THP-dr/drosos/Flowcharts/Xatz_allFlowcharts.pdf

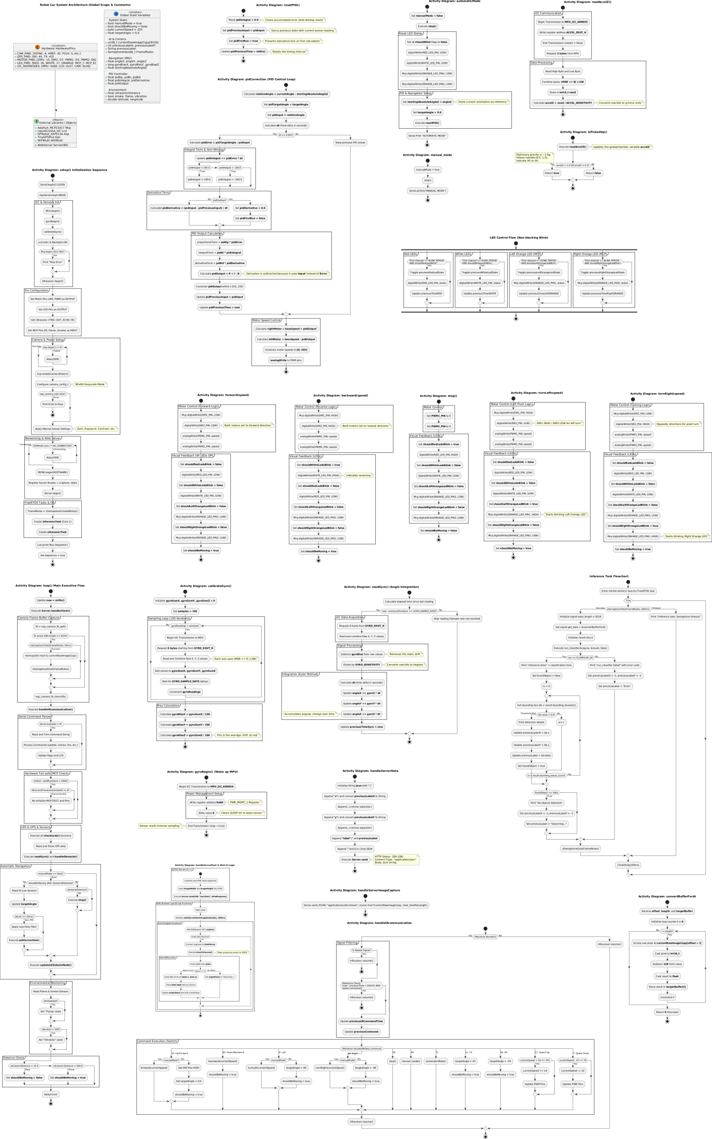
[picture p78: page 1]
