THP-dr/drosos/docs/cad/chassis_back.png

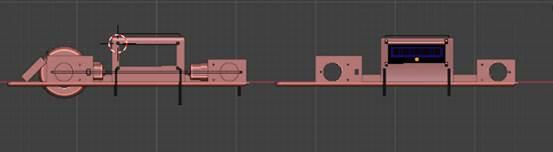
docs/cad/chassis_back.png
