THP-dr/drosos/docs/cad/chassis_front.png

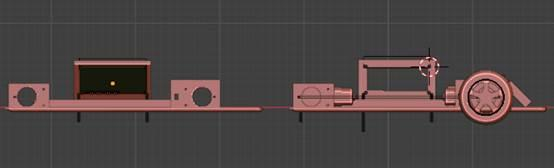
docs/cad/chassis_front.png
