THP-dr/drosos/docs/flowcharts/checkLeds.png

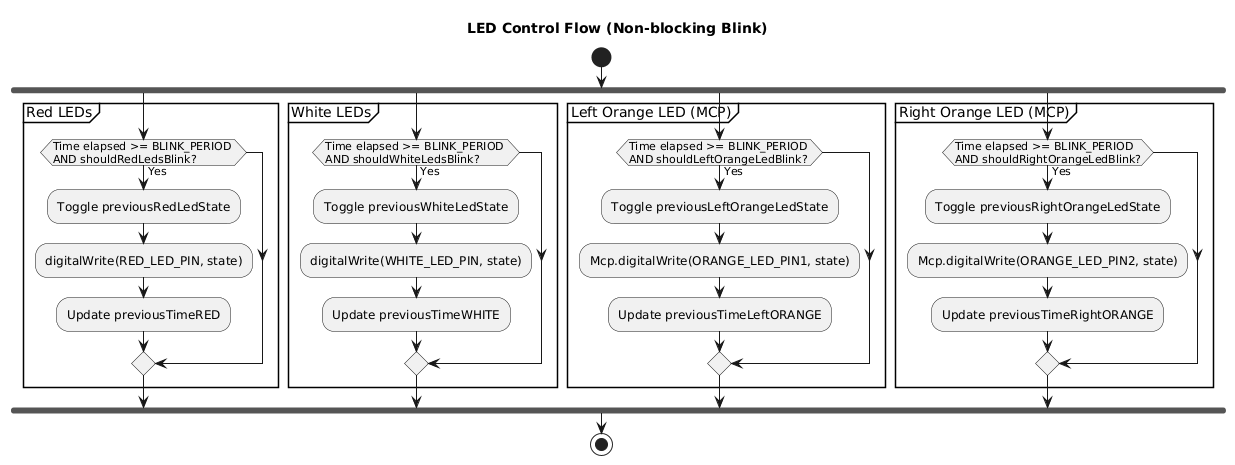
docs/flowcharts/checkLeds.png
