THP-dr/drosos/docs/flowcharts/early/sensors.png

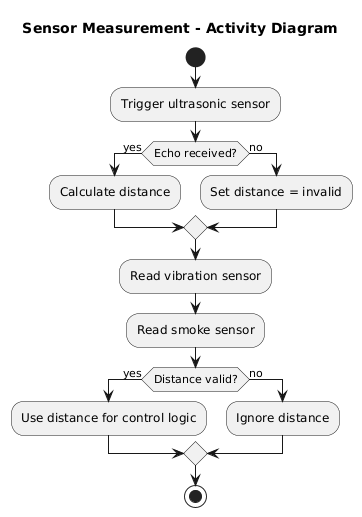
docs/flowcharts/early/sensors.png
