THP-dr/drosos/docs/flowcharts/early/streaming-2.png

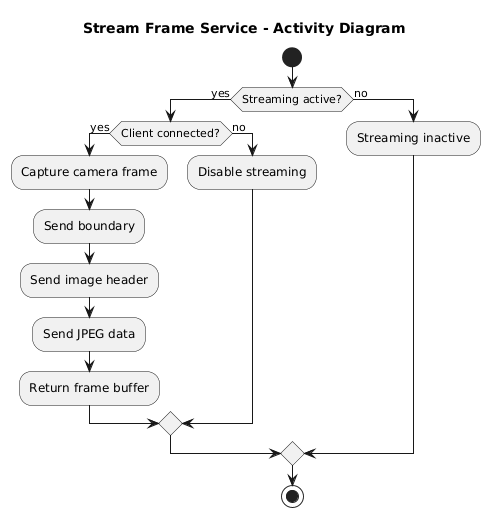
docs/flowcharts/early/streaming-2.png
