THP-dr/drosos/docs/flowcharts/handleImageCapture.png

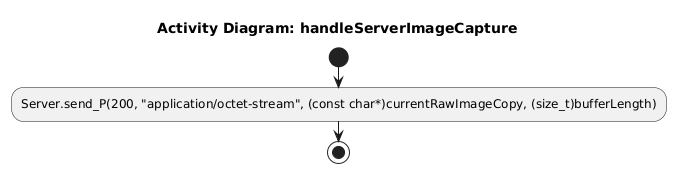
docs/flowcharts/handleImageCapture.png
