THP-dr/drosos/docs/flowcharts/handleIRcommunication.png

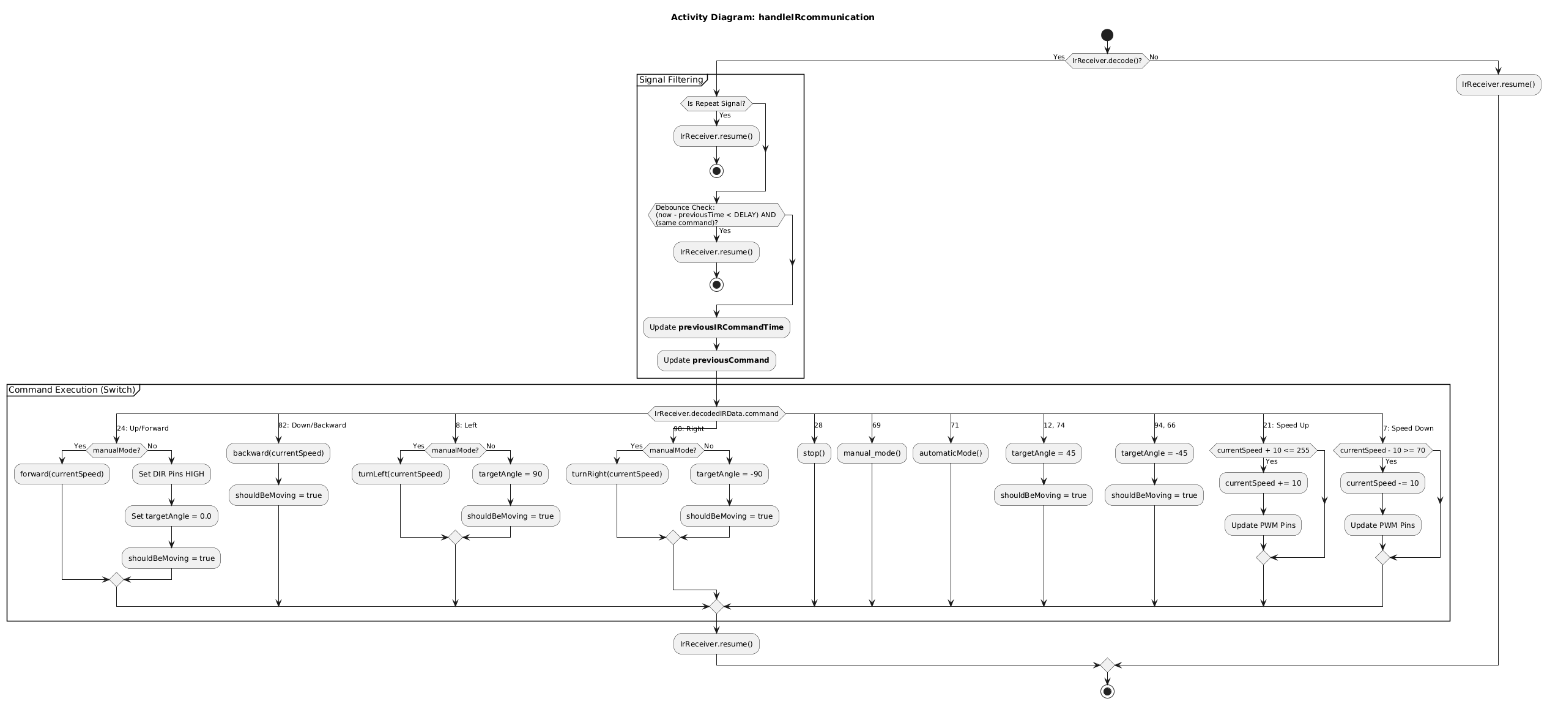
docs/flowcharts/handleIRcommunication.png
