THP-dr/drosos/docs/flowcharts/readGyro.png

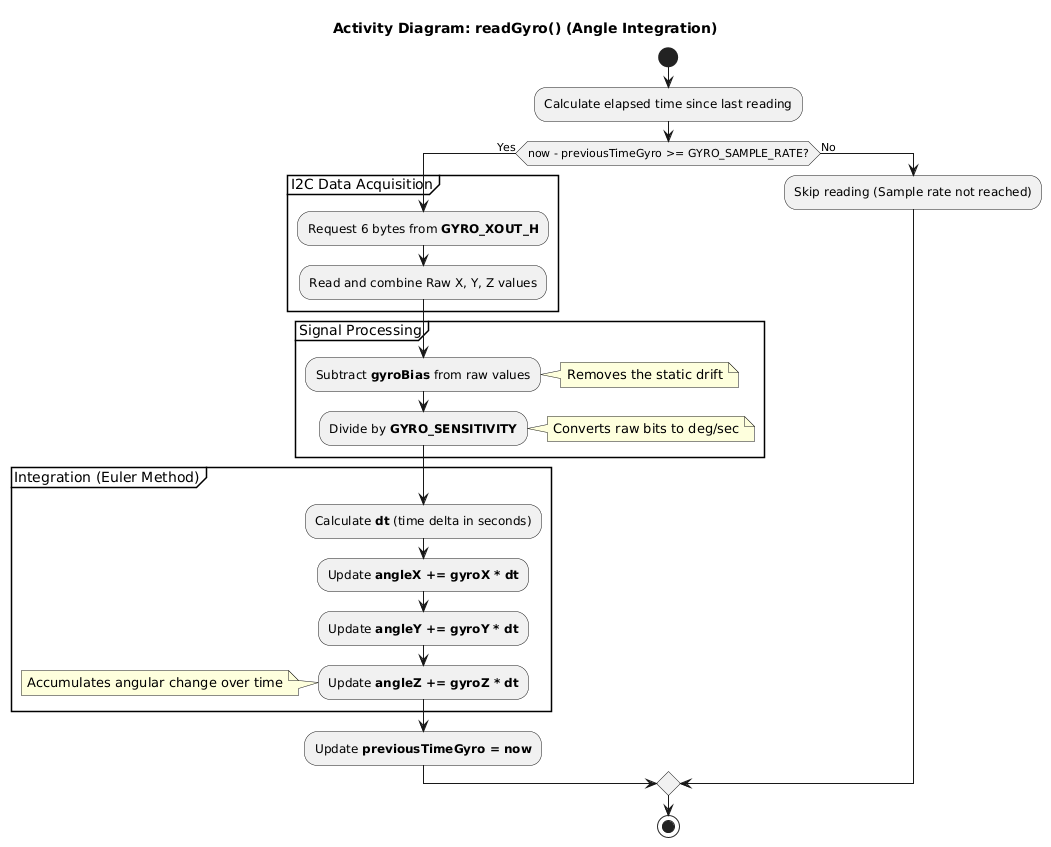
docs/flowcharts/readGyro.png
