THP-dr/drosos/docs/flowcharts/stop.png

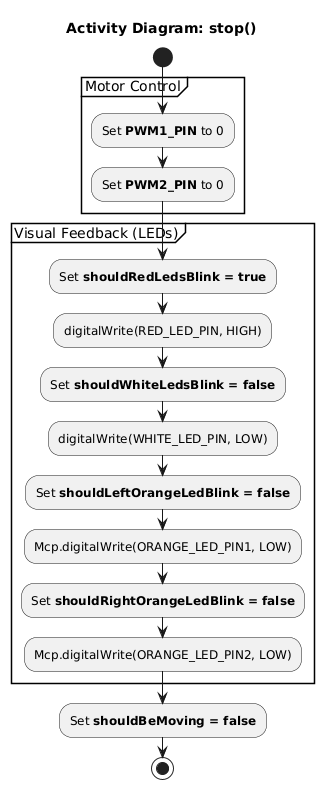
docs/flowcharts/stop.png
