THP-dr/drosos/docs/flowcharts/telemetry-link.png

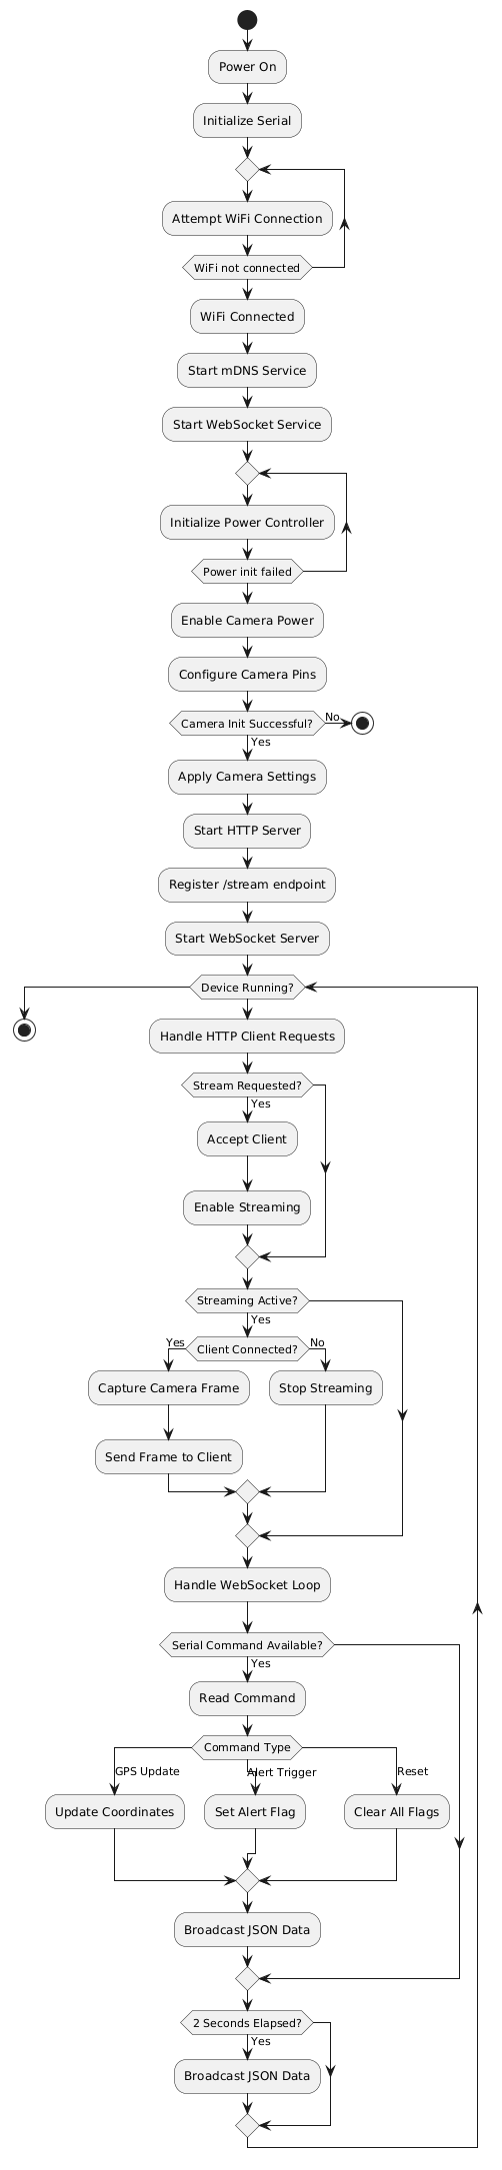
docs/flowcharts/telemetry-link.png
