THP-dr/drosos/docs/images/car_angled-view.jpg

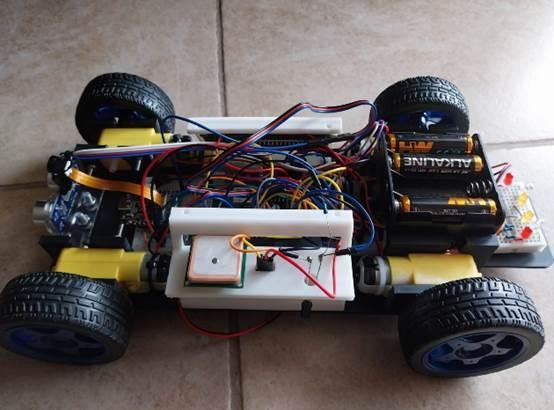
docs/images/car_angled-view.jpg
