THP-dr/drosos/docs/images/car_top-view-2.jpg

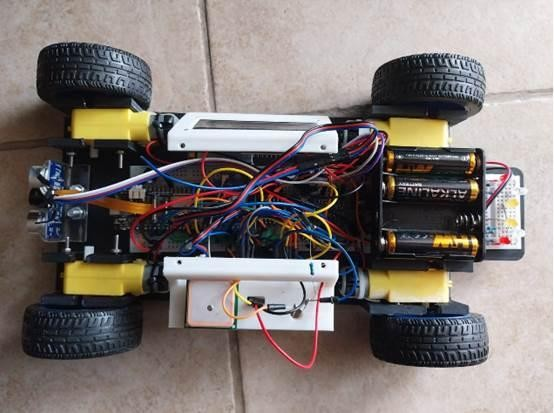
docs/images/car_top-view-2.jpg
