THP-dr/drosos/docs/line-detection/binarisation_left.png

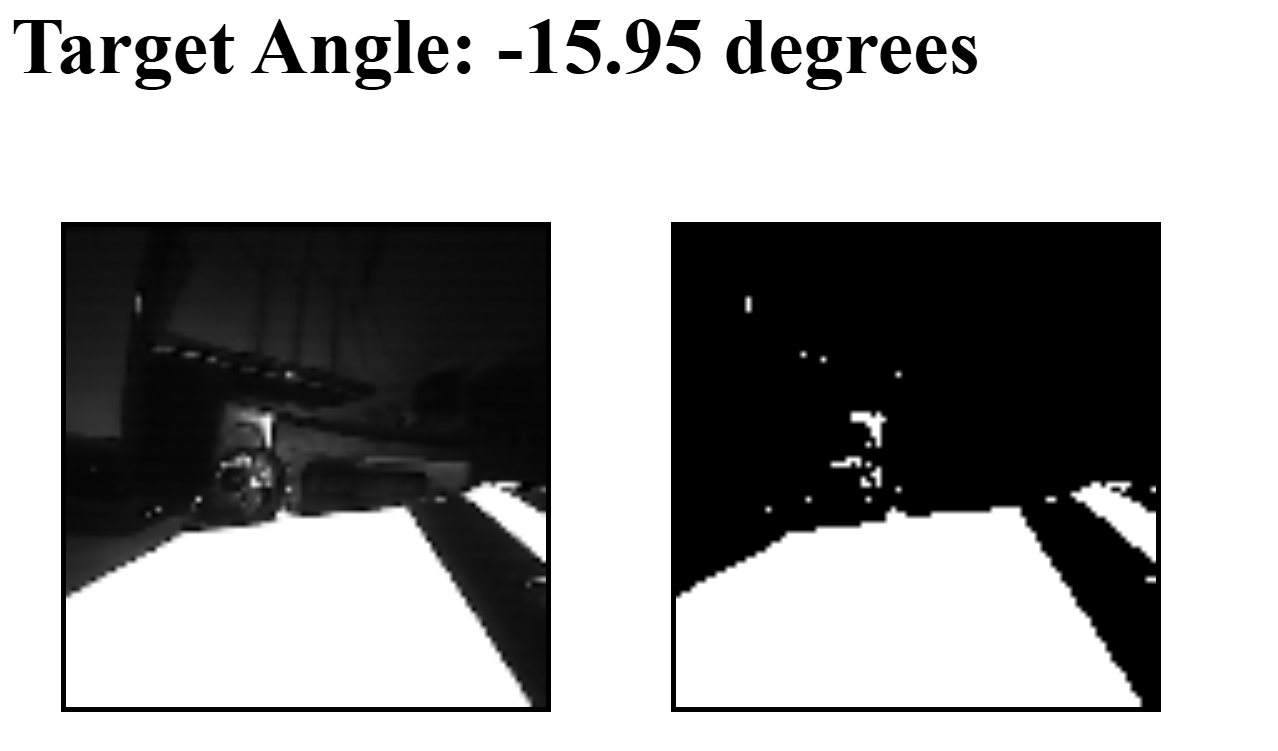
docs/line-detection/binarisation_left.png
