THP-dr/drosos/docs/line-detection/binarisation_right.png

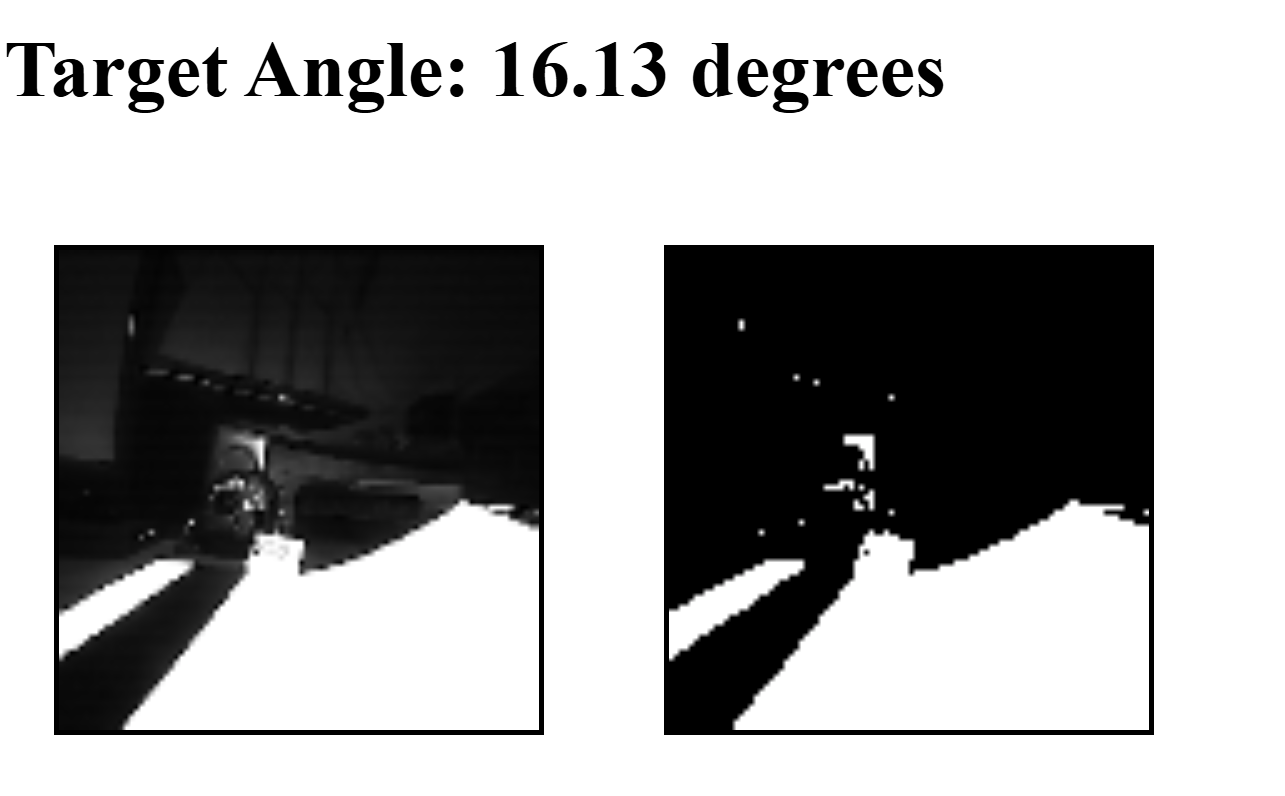
docs/line-detection/binarisation_right.png
