THP-dr/drosos/docs/ml/feature_explorer.png

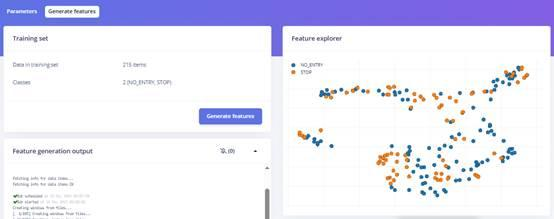
docs/ml/feature_explorer.png
