THP-dr/drosos/docs/ml/training_settings.png

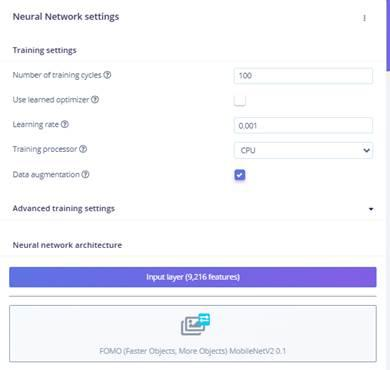
docs/ml/training_settings.png
