THP-dr/drosos/Flowcharts/Flowchart_combinedStreamAndWebSocketWithComments.png

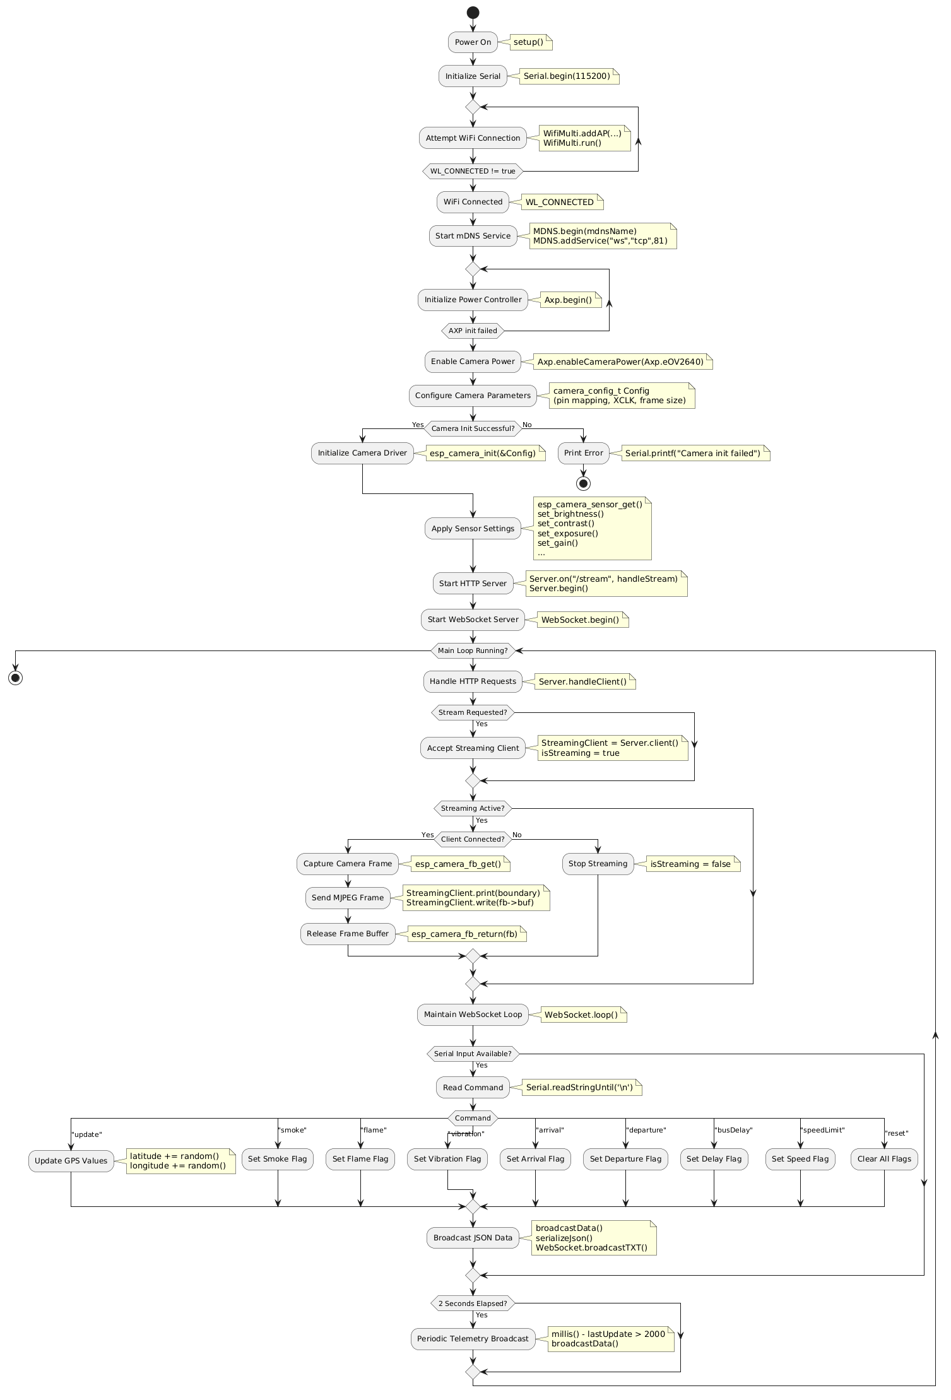
Flowcharts/Flowchart_combinedStreamAndWebSocketWithComments.png
