THP-dr/drosos/Flowcharts/ir.png

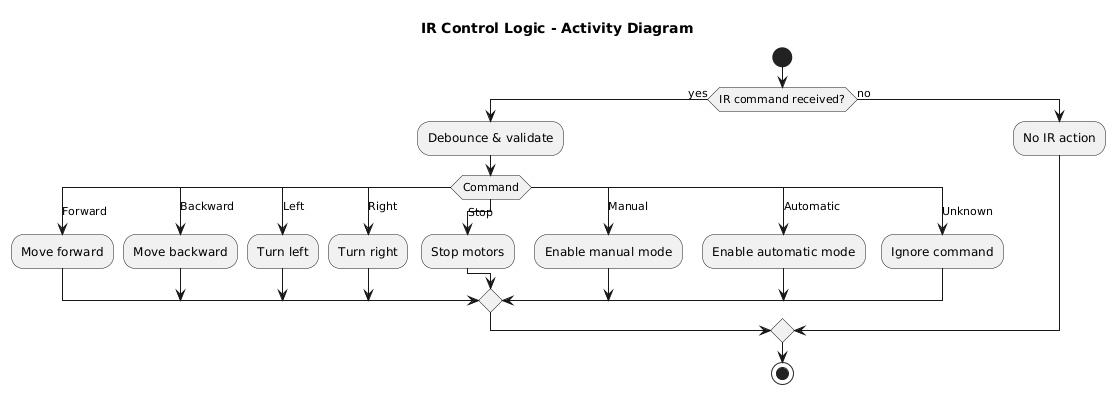
Flowcharts/ir.png
