THP-dr/drosos/Flowcharts/main_loop.png

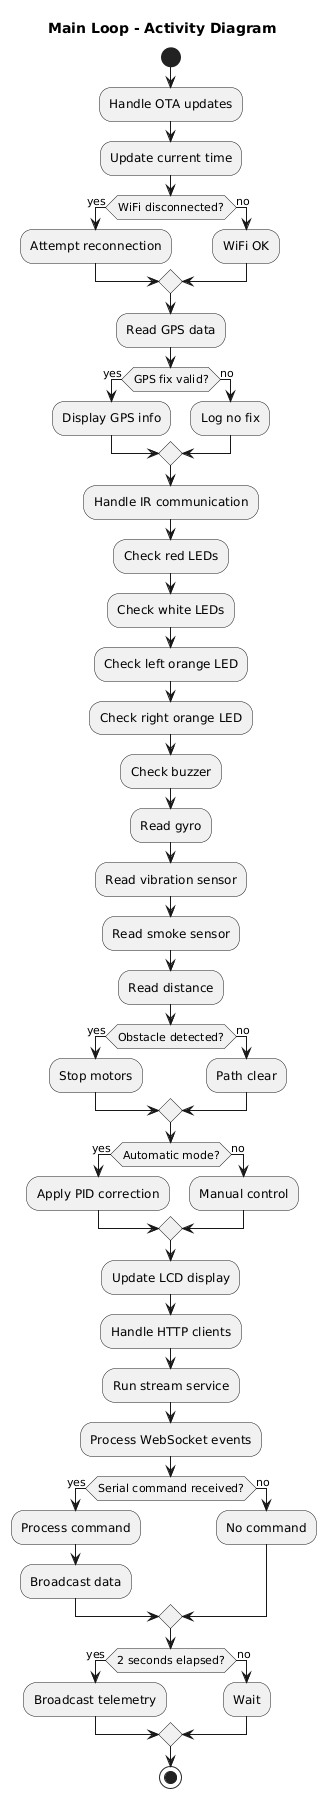
Flowcharts/main_loop.png
