THP-dr/drosos/Flowcharts/pid_correction.png

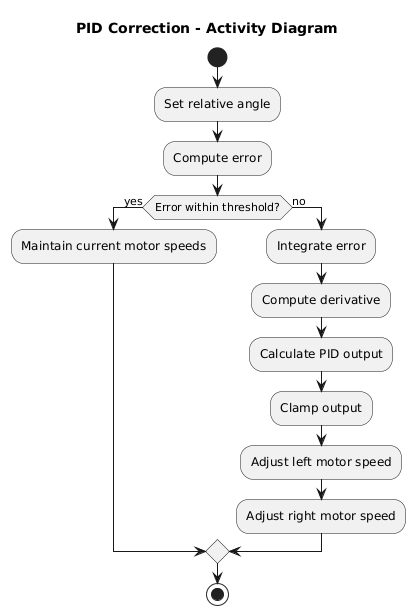
Flowcharts/pid_correction.png
