THP-dr/drosos/Flowcharts/streaming.png

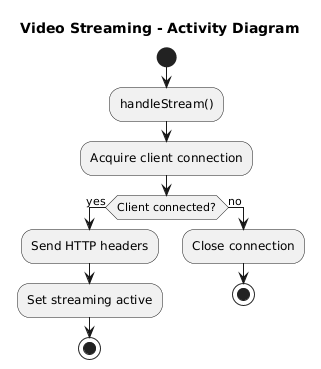
Flowcharts/streaming.png
