THP-dr/drosos/Flowcharts/Xatz_gyroBegin().png

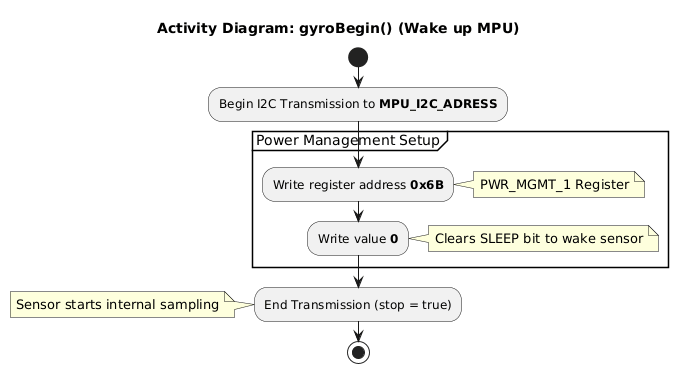
Flowcharts/Xatz_gyroBegin().png
