THP-dr/drosos/Flowcharts/Xatz_loop().png

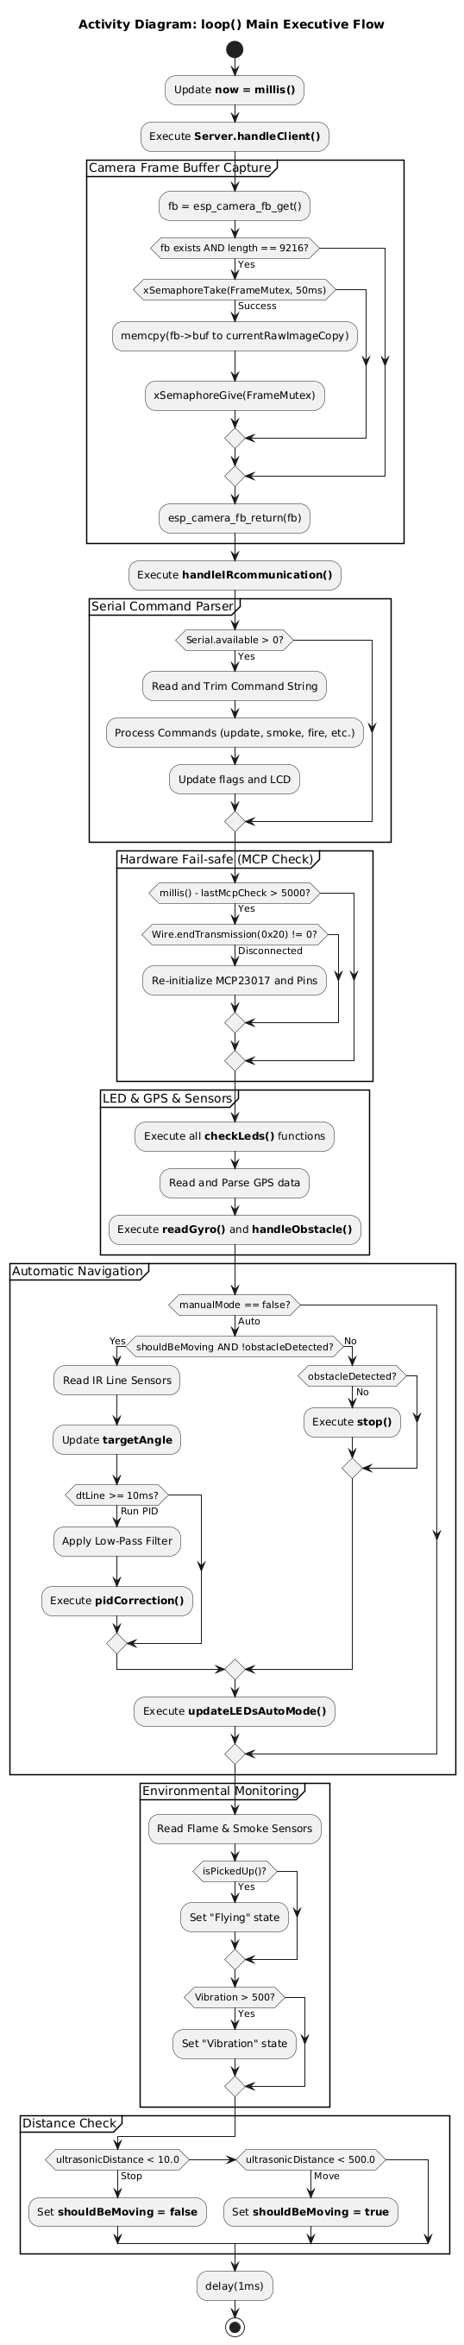
Flowcharts/Xatz_loop().png
