THP-dr/drosos/Flowcharts/Xatz_resetPID().png

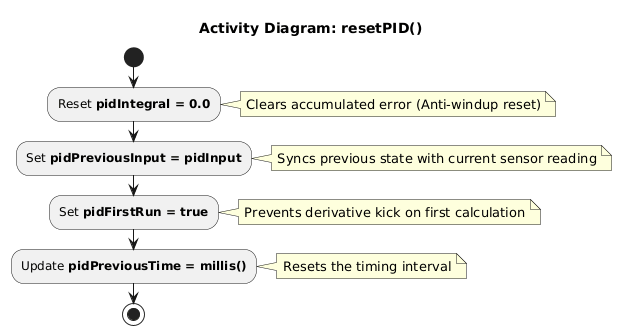
Flowcharts/Xatz_resetPID().png
