THP-dr/drosos/docs/flowcharts/setup.png

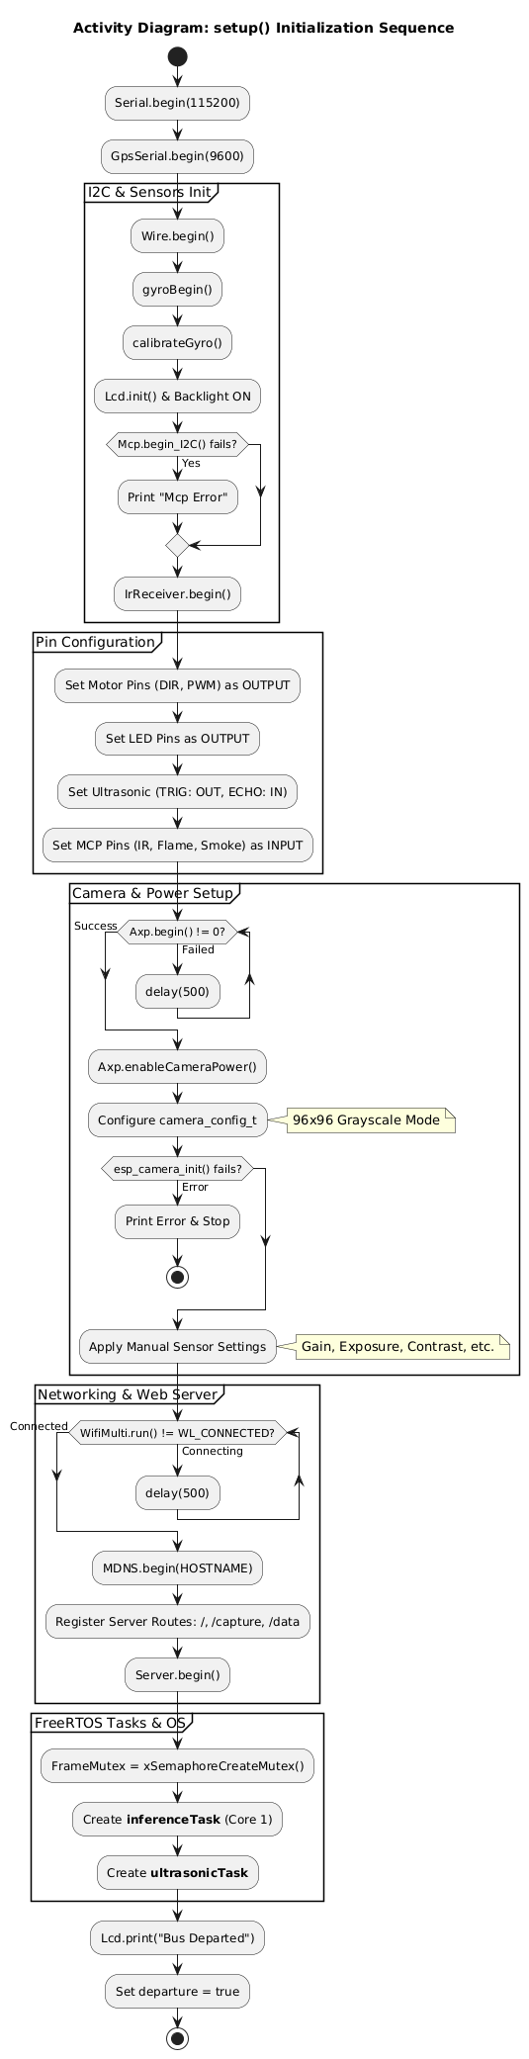
docs/flowcharts/setup.png
