THP-dr/drosos/docs/images/car_wiring-top.jpg

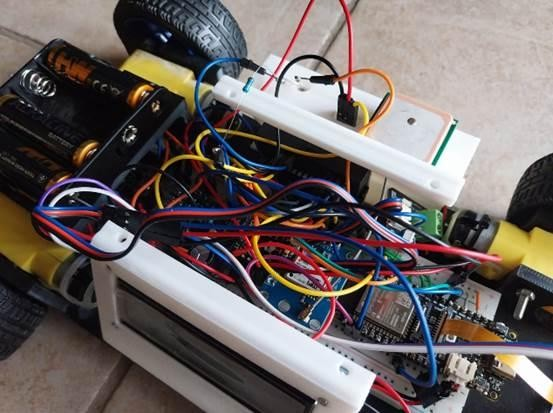
docs/images/car_wiring-top.jpg
