THP-dr/drosos/docs/images/electronics_wiring-closeup.jpg

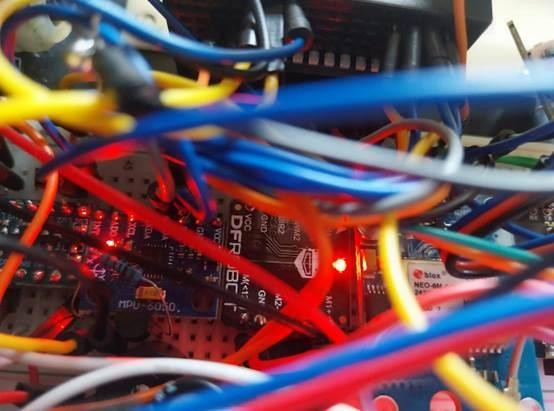
docs/images/electronics_wiring-closeup.jpg
