THP-dr/drosos/Flowcharts/boot&setup.png

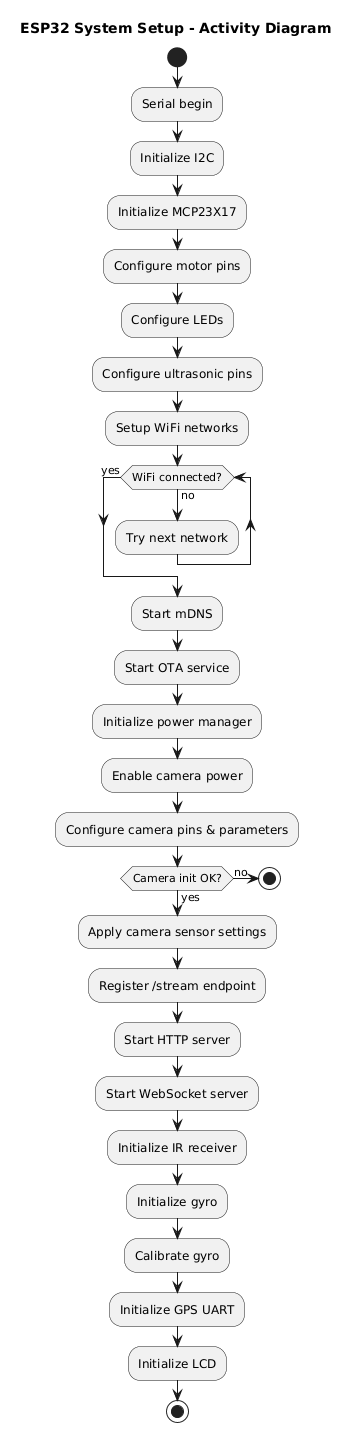
Flowcharts/boot&setup.png
