THP-dr/drosos/app/SafeRoute/Car_Test2Content/images/bus.png

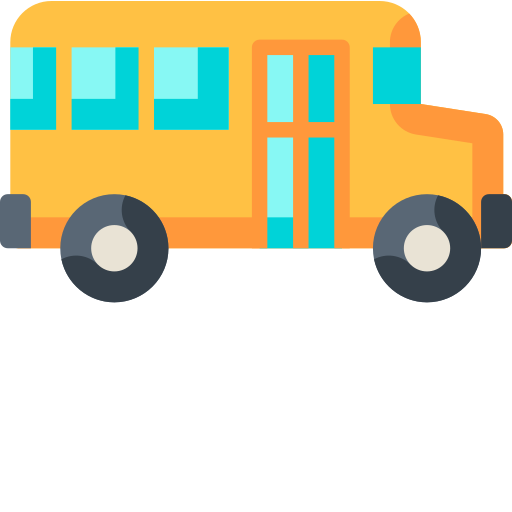
app/SafeRoute/Car_Test2Content/images/bus.png
