THP-dr/drosos/app/SafeRoute/Car_Test2Content/images/cam2.png

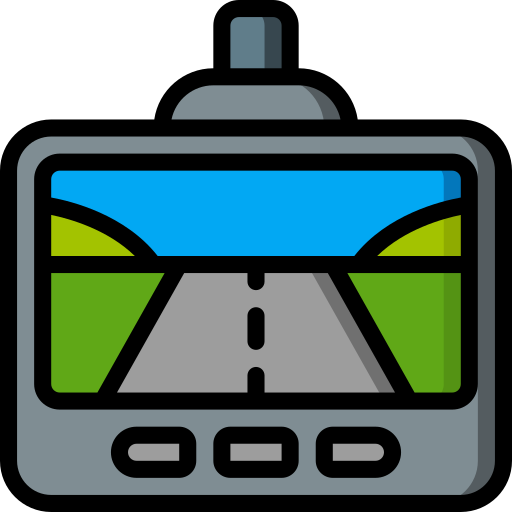
app/SafeRoute/Car_Test2Content/images/cam2.png
