THP-dr/drosos/app/SafeRoute/Car_Test2Content/images/cam.png

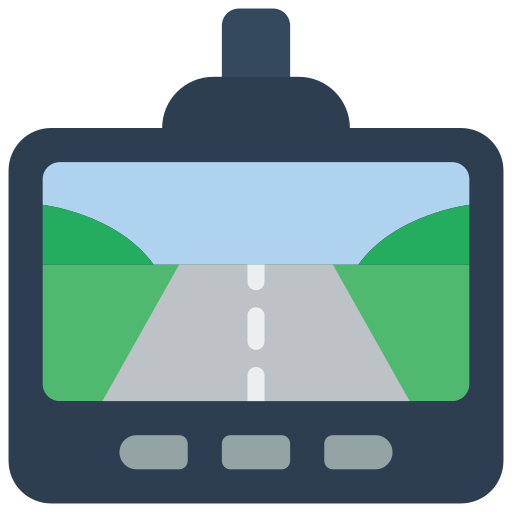
app/SafeRoute/Car_Test2Content/images/cam.png
