THP-dr/drosos/app/SafeRoute/Car_Test2Content/images/caution.png

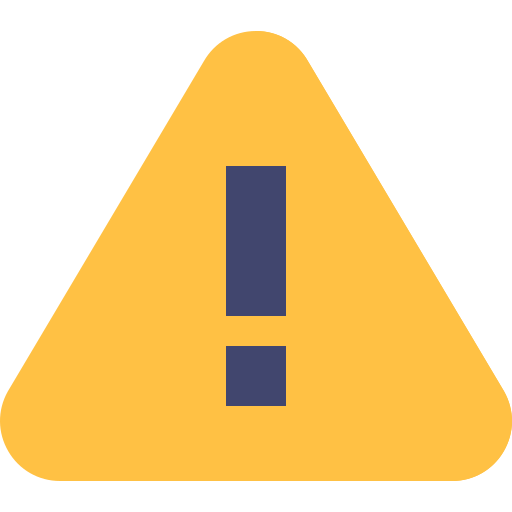
app/SafeRoute/Car_Test2Content/images/caution.png
