THP-dr/drosos/app/SafeRoute/Car_Test2Content/images/check2.png

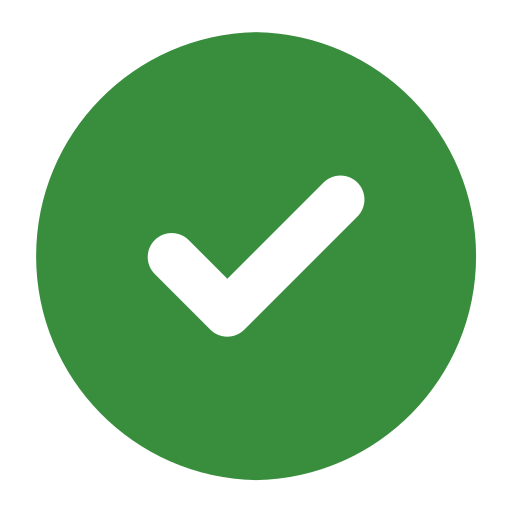
app/SafeRoute/Car_Test2Content/images/check2.png
