THP-dr/drosos/app/SafeRoute/Car_Test2Content/images/cross.png

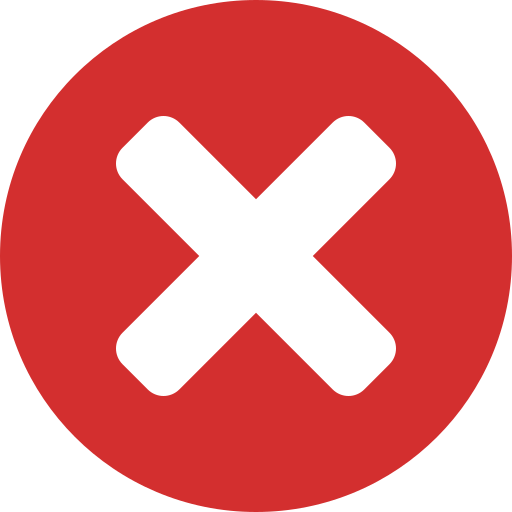
app/SafeRoute/Car_Test2Content/images/cross.png
