THP-dr/drosos/app/SafeRoute/Car_Test2Content/images/eng.png

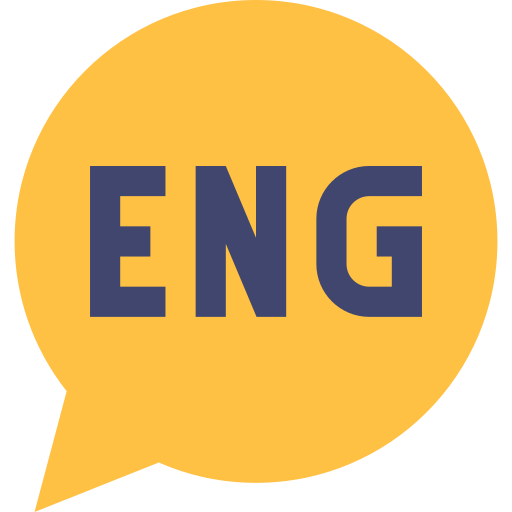
app/SafeRoute/Car_Test2Content/images/eng.png
