THP-dr/drosos/app/SafeRoute/Car_Test2Content/images/green.png

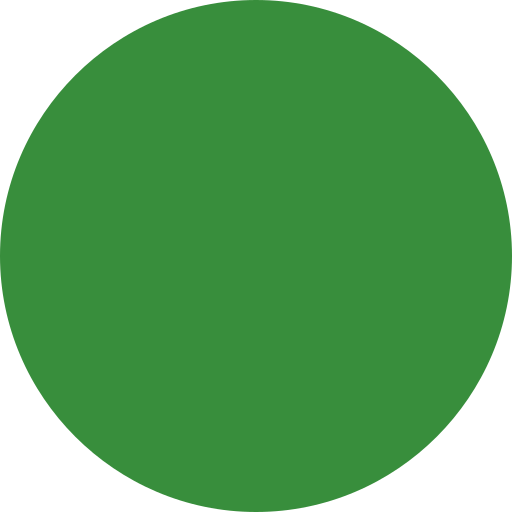
app/SafeRoute/Car_Test2Content/images/green.png
