THP-dr/drosos/app/SafeRoute/Car_Test2Content/images/map.png

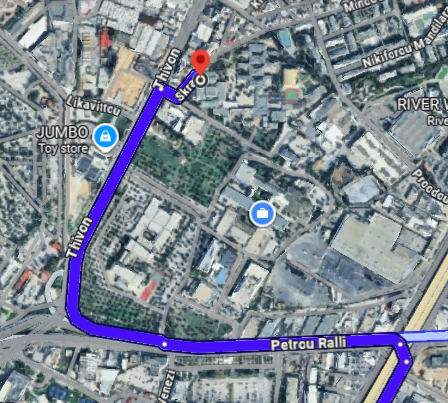
app/SafeRoute/Car_Test2Content/images/map.png
