THP-dr/drosos/app/SafeRoute/Car_Test2Content/images/phone.png

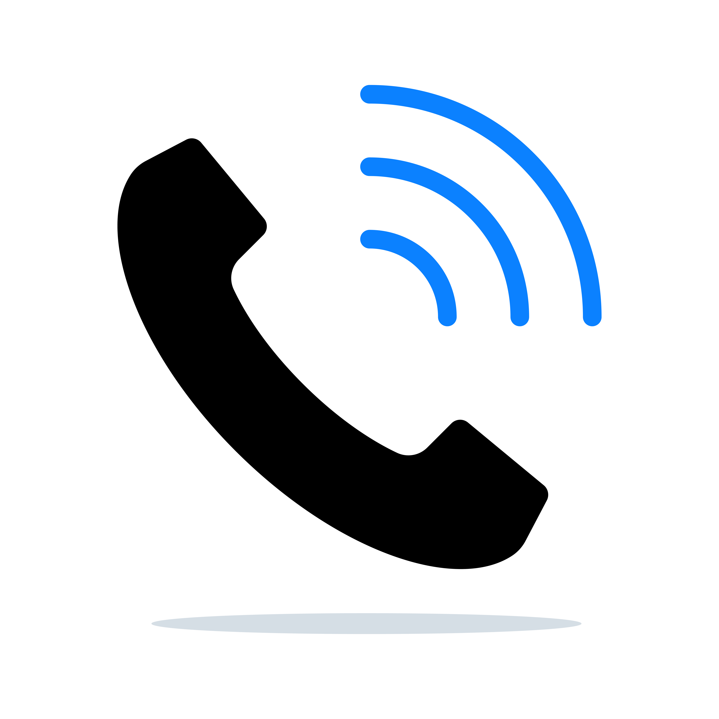
app/SafeRoute/Car_Test2Content/images/phone.png
