THP-dr/drosos/app/SafeRoute/Car_Test2Content/images/SafeRouteDark.png

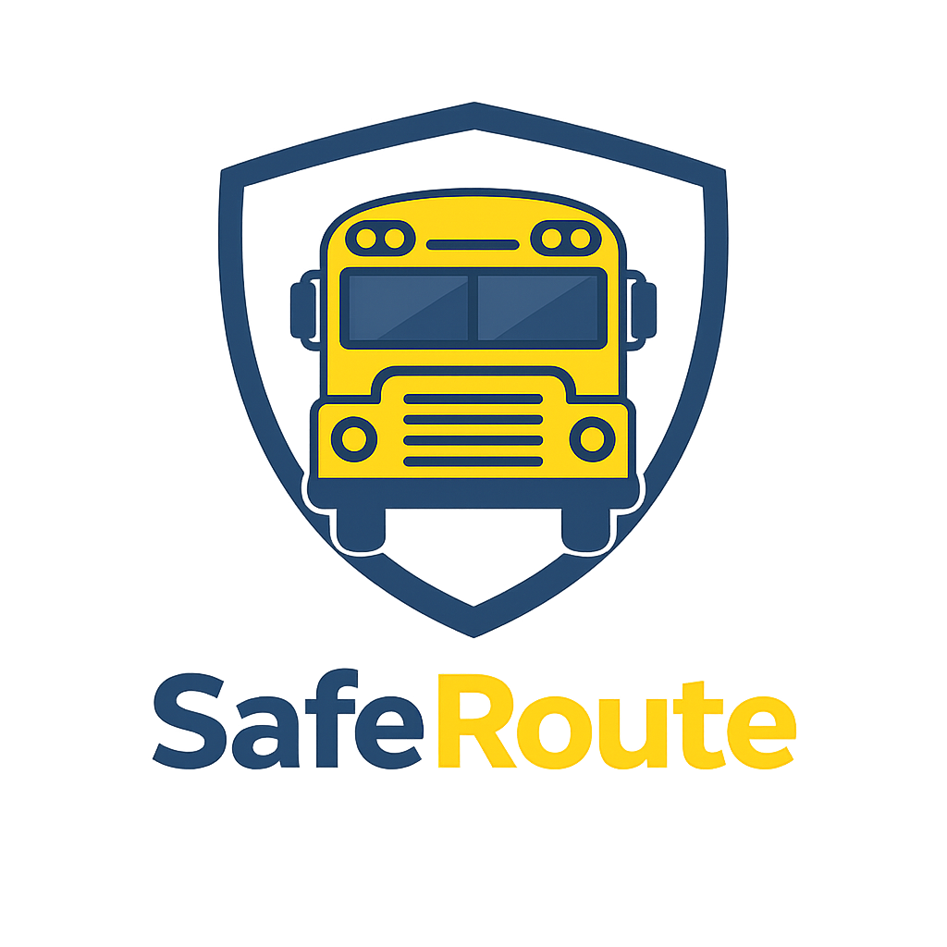
app/SafeRoute/Car_Test2Content/images/SafeRouteDark.png
