THP-dr/drosos/app/SafeRoute/Car_Test2Content/images/school-bus.png

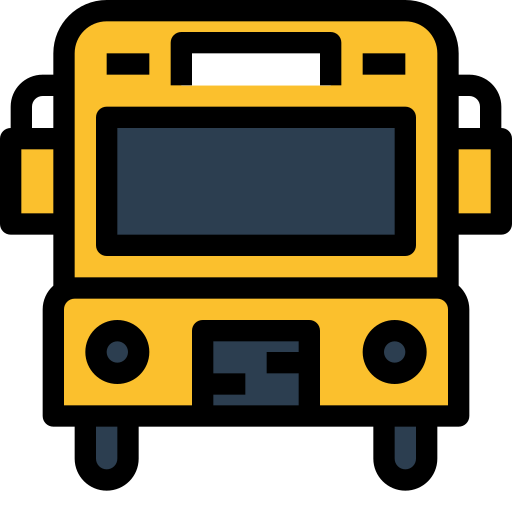
app/SafeRoute/Car_Test2Content/images/school-bus.png
