THP-dr/drosos/app/SafeRoute/Car_Test2Content/images/speaker.png

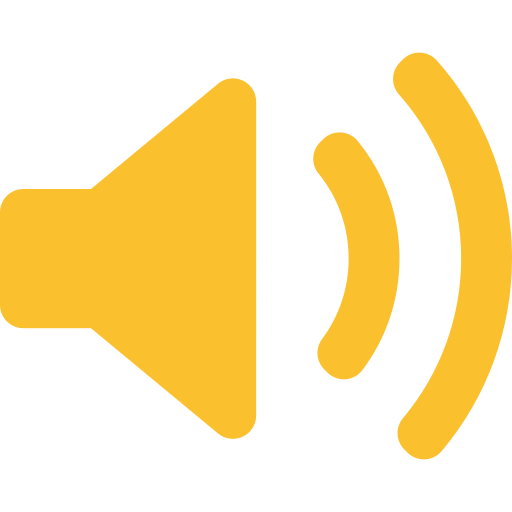
app/SafeRoute/Car_Test2Content/images/speaker.png
