THP-dr/drosos/app/SafeRoute/Car_Test2Content/images/telephone.png

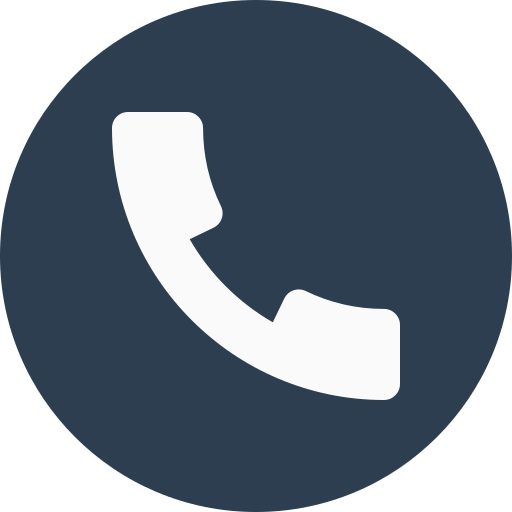
app/SafeRoute/Car_Test2Content/images/telephone.png
