THP-dr/drosos/app/SafeRoute/Car_Test2Content/images/tick.png

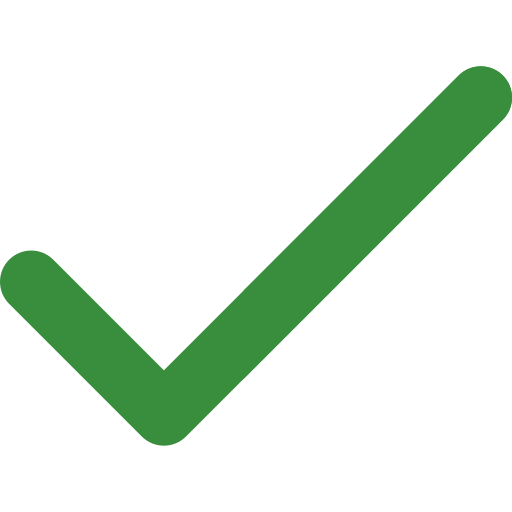
app/SafeRoute/Car_Test2Content/images/tick.png
