THP-dr/drosos/Car_Test2/Car_Test2Content/images/brightness-and-contrast.png

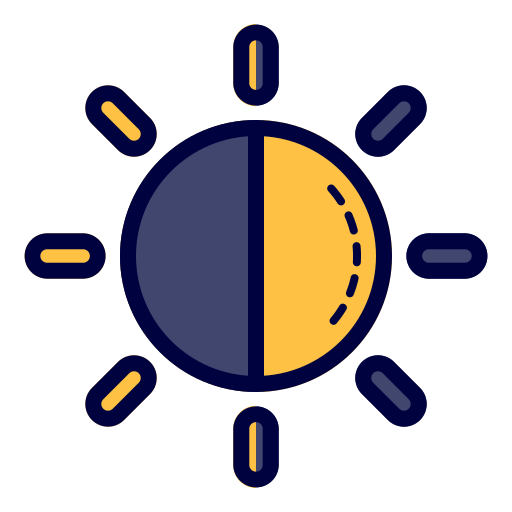
Car_Test2/Car_Test2Content/images/brightness-and-contrast.png
