THP-dr/drosos/Car_Test2/Car_Test2Content/images/check.png

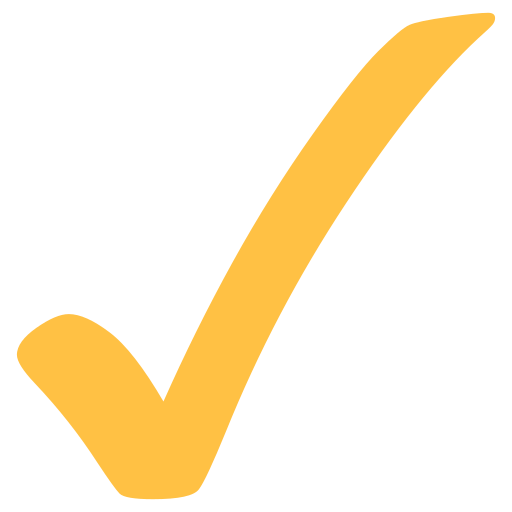
Car_Test2/Car_Test2Content/images/check.png
