THP-dr/drosos/Car_Test2/Car_Test2Content/images/map.jpg

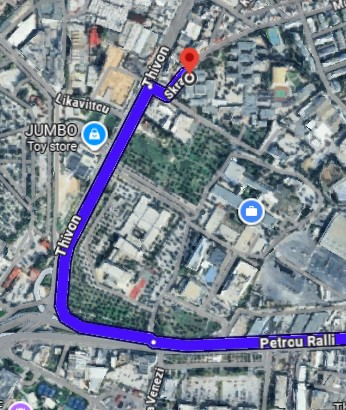
Car_Test2/Car_Test2Content/images/map.jpg
