THP-dr/drosos/Car_Test2/Car_Test2Content/images/school-bus-front-view.png

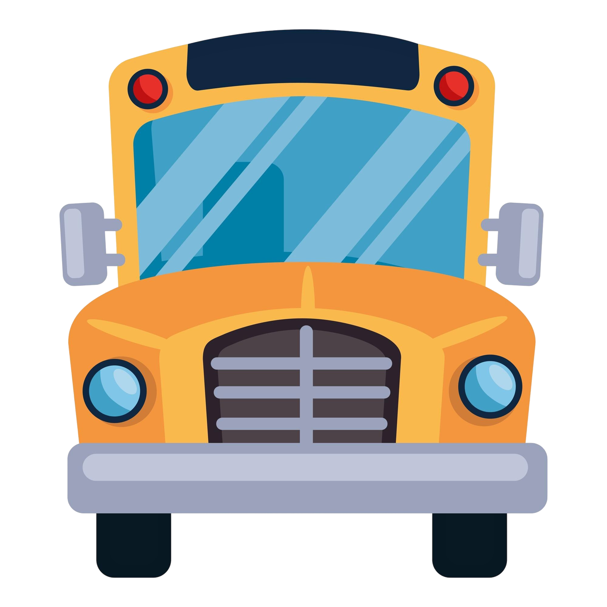
Car_Test2/Car_Test2Content/images/school-bus-front-view.png
