THP-dr/drosos/(commit log)

2026-01-19 Qt update - camera working
2026-01-21 Accelerometer Update
2026-01-31 Corrected input of AI model to -128 to 127
    [AI_withWebServer.ino]
2026-01-31 Corrected AI model input to int8_t (-128 to 127)
    [AI_withWebServer.ino]
2026-02-04 Ultrasonic added
2026-02-07 obstacle detection & leds
2026-02-10 Added IR line sensor logic
2026-02-10 Flowchart and Schematic update
2026-02-11 Fixed ultrasonic and led problems
    [AI_withEverything.ino]
2026-10-12 Reorganize repository into firmware/, app/, electronics/ and docs/
    Pure renames, no content changes. Every sketch now lives in a folder with
    the same name as its .ino so the Arduino IDE opens it directly: the final
    firmware is firmware/SchoolBus, the app link is firmware/TelemetryLink,
    the camera line detection and ESP-DSP benchmark are experiments, and the
    earlier development versions are numbered under firmware/archive. The Qt
    project moves to app/SafeRoute and the Edge Impulse library to
    firmware/libraries.
2026-10-12 Add README, firmware/ml/app docs, BOM, images and .gitignore
    README covers the system, what is implemented versus the report, measured
    numbers, pin map, build steps and known limitations. ml/README documents
    the Edge Impulse training, results and the PSRAM patch to the library.
    Photos, CAD renders, model results and app screenshots are taken from the
    project report, which is added as docs/report_el.pdf.
2026-10-12 Added compile button and library versions in README
